JonasGMorsch/PI2/README.md

# Projeto Integrador 2 : [Domótica](/Contextualizacao/README.md)
 
## Projeto utilizando modelo [CDIO](http://www.cdio.org/about) :
* [Concepção](/Concepcao/README.md) 
* [Design](/Design/README.md) 
* [Implementação](/Implemantacao/README.md)
* [Operação](https://youtu.be/mp2Dxx6MhjE)
