JonasGMorsch/PI2/Contextualizacao/README.md

# Contextualizando o tema
  A Domótica, do francês Domotique (Domus significa casa e Imotique significa automática), hoje mais referida como automação residencial, tem como objetivo primário a automação de componentes eletrônicos residenciais através de redes como WiFi, Bluetooth, LoRa em configurações simples, mesh, bridge entres outras, visando comunicar dados entre múltiplos dispositivos, criando serviços que podem ser automatizados e agendados pelo dono da residência.

  Como objetivo secundário é o controle a distância, quando esses sistemas possuem não somente comunicação entre si, mas comunicação com a Internet, ampliando significativamente a capacidade de automação já que servidores podem participar desse grupo de dispositivos, tomando decisões além das do dono da residência.

  Como objetivo terciário temos o comportamento natural, chamado de “big data” quando não somente os dispositivos tem controle por servidores, mas quando esses servidores que entregam os serviços de automação também armazenam os dados, e compartilham esses dados com servidores de análise, que, utilizando de múltiplas técnicas de processamento de dados é possível descrever e então prever o comportamento médio de uma cidade, e automatizá-la como um todo, temos exemplos primordiais dessa tecnologia utilizando smartfones, como a [WiGLE](https://wigle.net/), que utiliza da rede, gps e dispositivos wifi para um mapa de rede que dispensa gps para áreas urbanas.

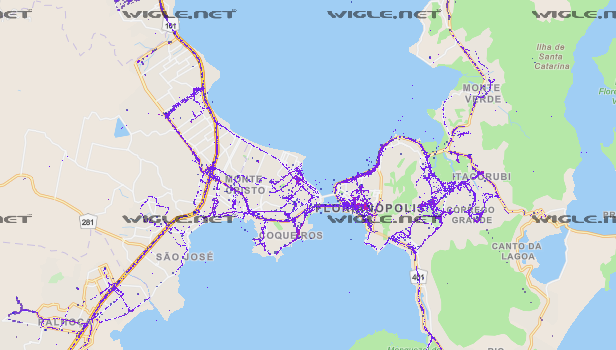
[picture p16: Contextualizacao/Imagem 1.png]
Mapa de Redes wifi da região
