JonasGMorsch/PI2/(list of files, cad)

Other CAD files:
Concepcao/tutorialcad.com_CT-21 48m2.dwg
