JonasGMorsch/PI2/Implemantacao/IRrecvDumpV2/Teste_VS1838.png

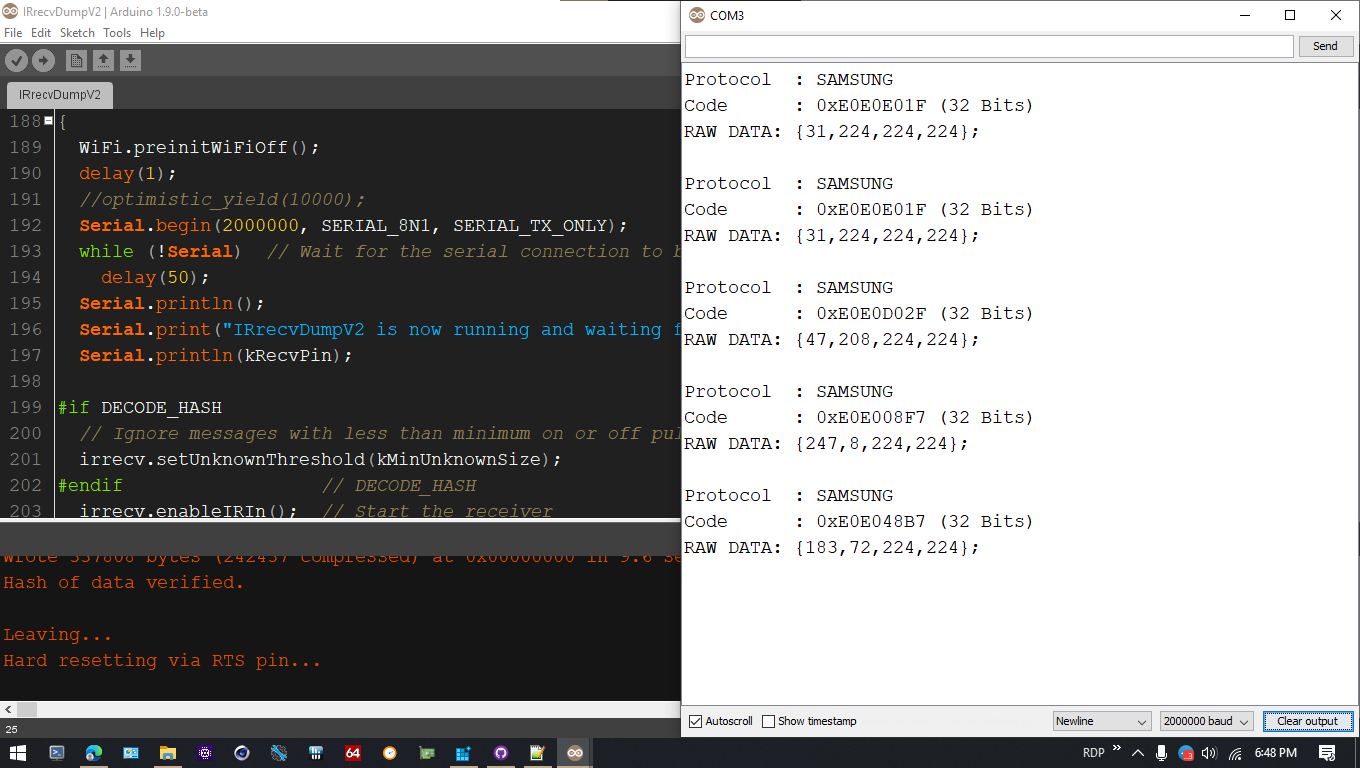
Implemantacao/IRrecvDumpV2/Teste_VS1838.png
