JonasGMorsch/PI2/(list of files, drawings)

Other design files:
Design/Circuito Completo.pdsprj
Design/PI2.fzz
