JonasGMorsch/PI2/(commit log)

2021-06-17 Mudança dos arquivos de apresentação para uma pasta separada
2021-06-17 Criação de todos os tópicos CDIO a serem preenchidos no decorren do semertre
2021-06-17 Alteração de nomes, melhorar a organização do projeto
2021-06-17 Colocando arquivos em /Concepção
    [tutorialcad.com_CT-21 48m2.dwg]
2021-06-17 teste de readme por diretório
2021-06-17 Trocando nomes dos .md para readme
    mostrar o texto descrito diretamente ao entrar no folder em questão
2021-06-20 Resolvendo Bug nuvem mega + github desktop
    [JONAS_MQTT.h, MQTT_JONAS_AMP.ino]
2021-07-07 arquivos do projeto
    [PI2.fzz]
2021-07-08 Preparando função para o FM62429
2021-08-19 Create MAPEAMENTO DE TECLAS.txt
    Mapeando todas as teclas do controle, esses códigos podem ser usados tanto para emissão quanto recepção pelo MCU, por exemplo, é possível aumentar e abaixar o volume do som capturando as teclas de volume do controle, assim como é possivel enviar um sinal para ligar ou desligar a tv pelo MCU
2021-09-07 Mudança de nome da pasta projeto, para design, montando circuito complerto no proteus
    [Circuito Completo.pdsprj, PI2.fzz]
2021-09-07 Update Circuito Completo.pdsprj
    [Circuito Completo.pdsprj]
2021-09-07 Envio do Esquemático completo, continuando a implementação do código
    [Circuito Completo.pdsprj]
2021-09-09 Códigos de Validação
2021-09-09 Adicionando sensor de temperatura
2021-09-09 Correção de bugs
2021-09-09 Adicionando sistema de controle de teperatura otimizado
    tem como objetivo manter a faixa de temperatura mais próxima á escohida, pois o sensor do a/c tem tolerâncias muito maiores, além da proximidade do sensor com o ar quente ou frio que atrapalha a precisão
2021-09-09 Adicionando mais funções pelo controle remoto da TV, correção de bugs
    [MQTT_JONAS_AMP.ino]
2021-09-09 correção de bugs e comentários
    [MQTT_JONAS_AMP.ino]
2021-09-09 adicionado volume de subwoofer independente, limpeza e conserto de bugs em Temp_Check()
    [JONAS_MQTT.h, MQTT_JONAS_AMP.ino]
2021-09-13 Avoid turn on tv on or off after a mcu restart
    [JONAS_MQTT.h, MQTT_JONAS_AMP.ino]
2021-09-14 novas imagens de implementação
